BigIskander/PlantWatering/photo/IMG_20230401_112216.jpg

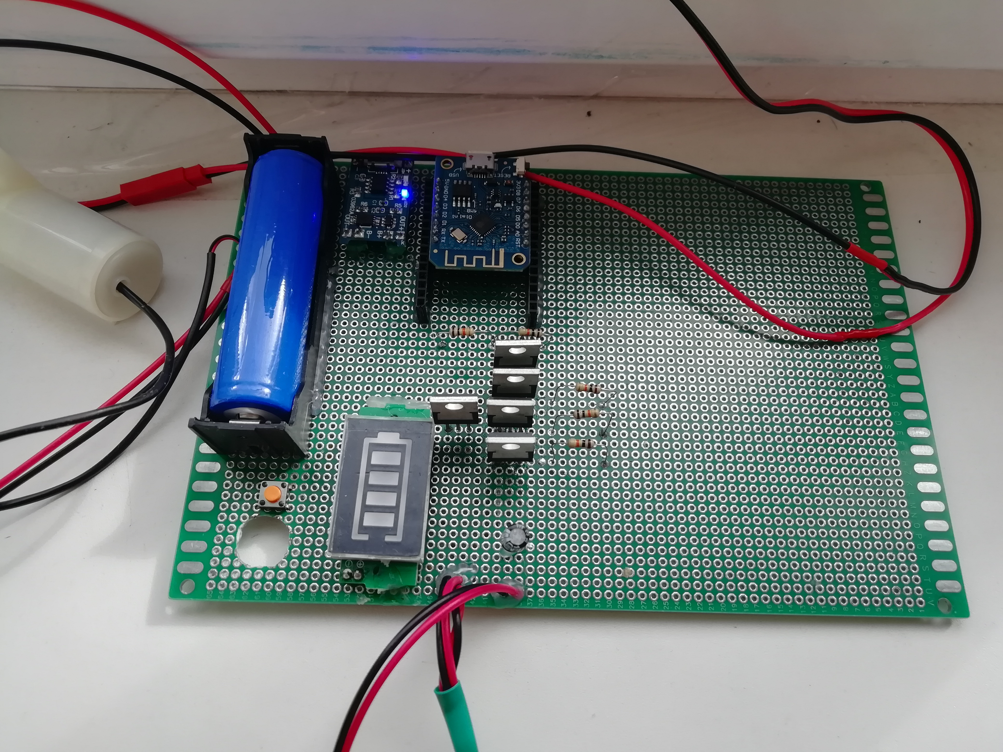
photo/IMG_20230401_112216.jpg
