BigIskander/PlantWatering/photo/IMG_20230612_072729.jpg

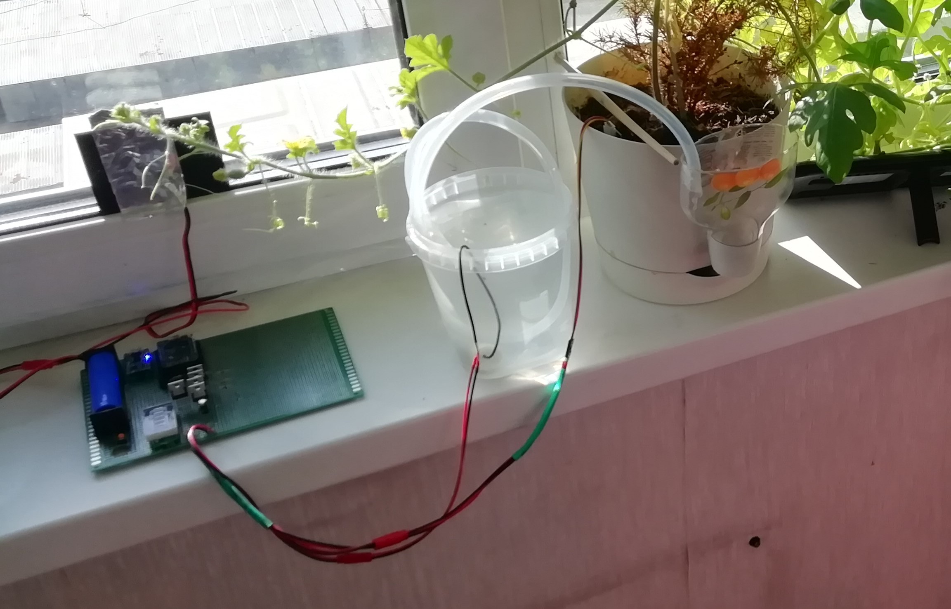
photo/IMG_20230612_072729.jpg
