BigIskander/PlantWatering/photo/moisture2.png

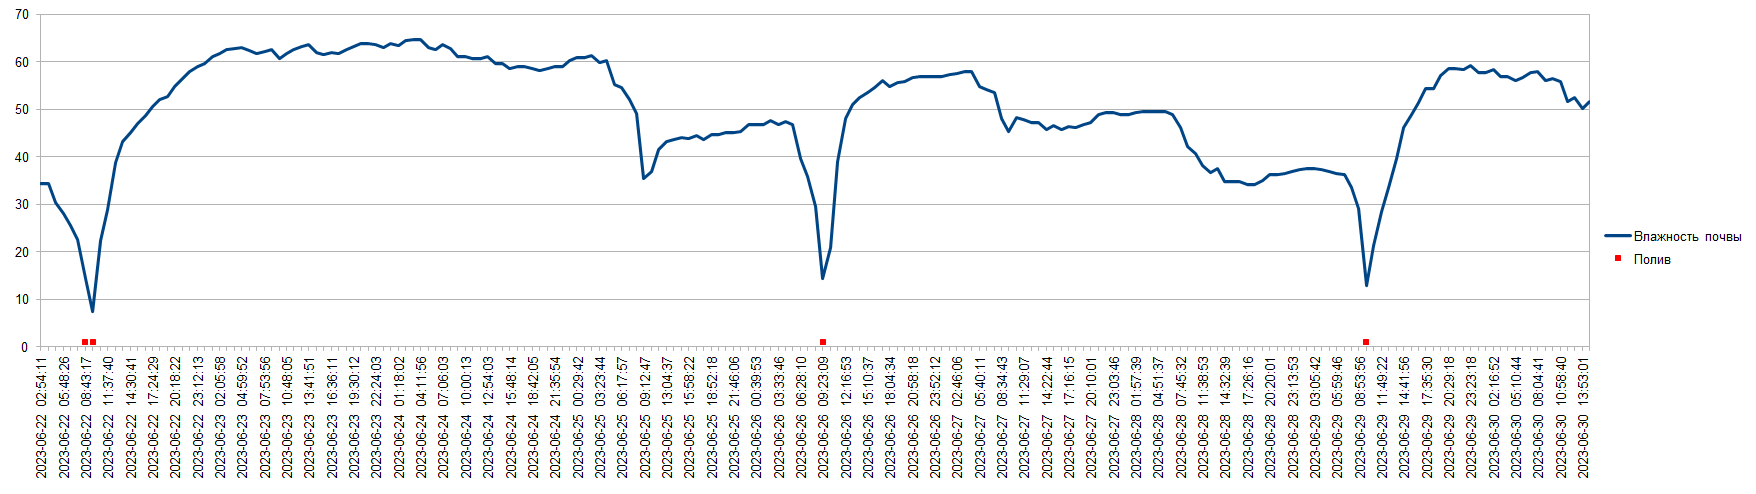
photo/moisture2.png
