BigIskander/PlantWatering/photo/moisture.png

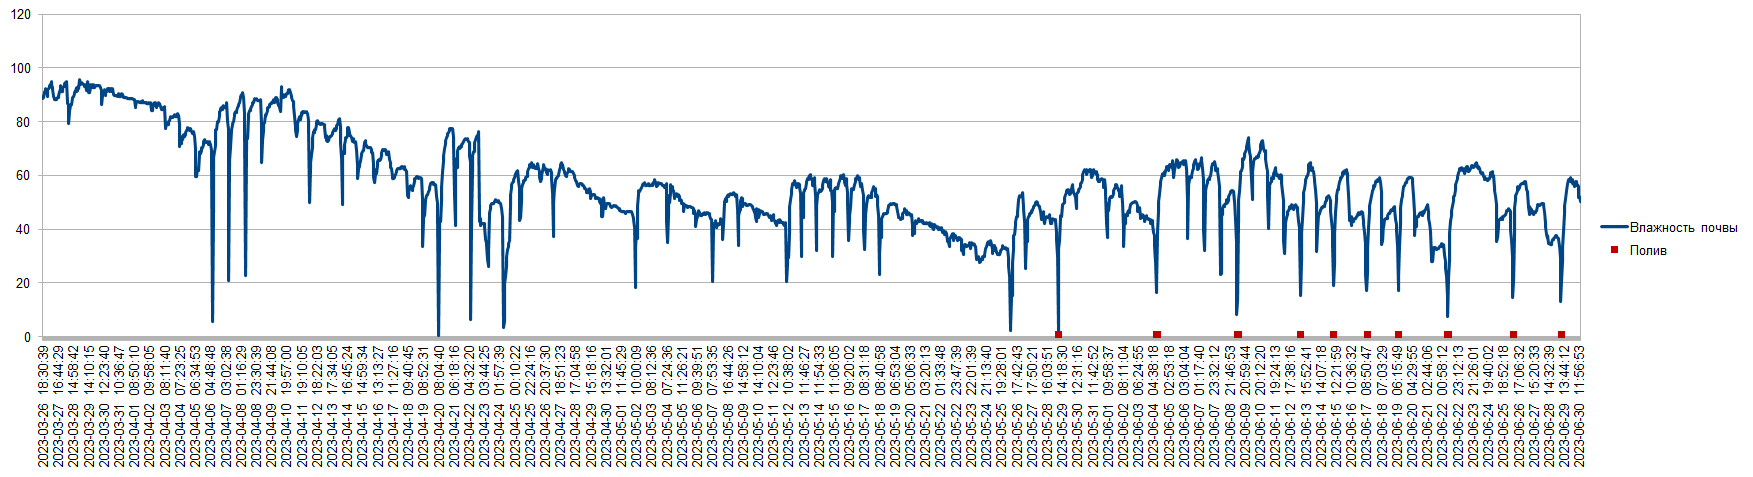
photo/moisture.png
