BigIskander/PlantWatering/photo/voltage2.png

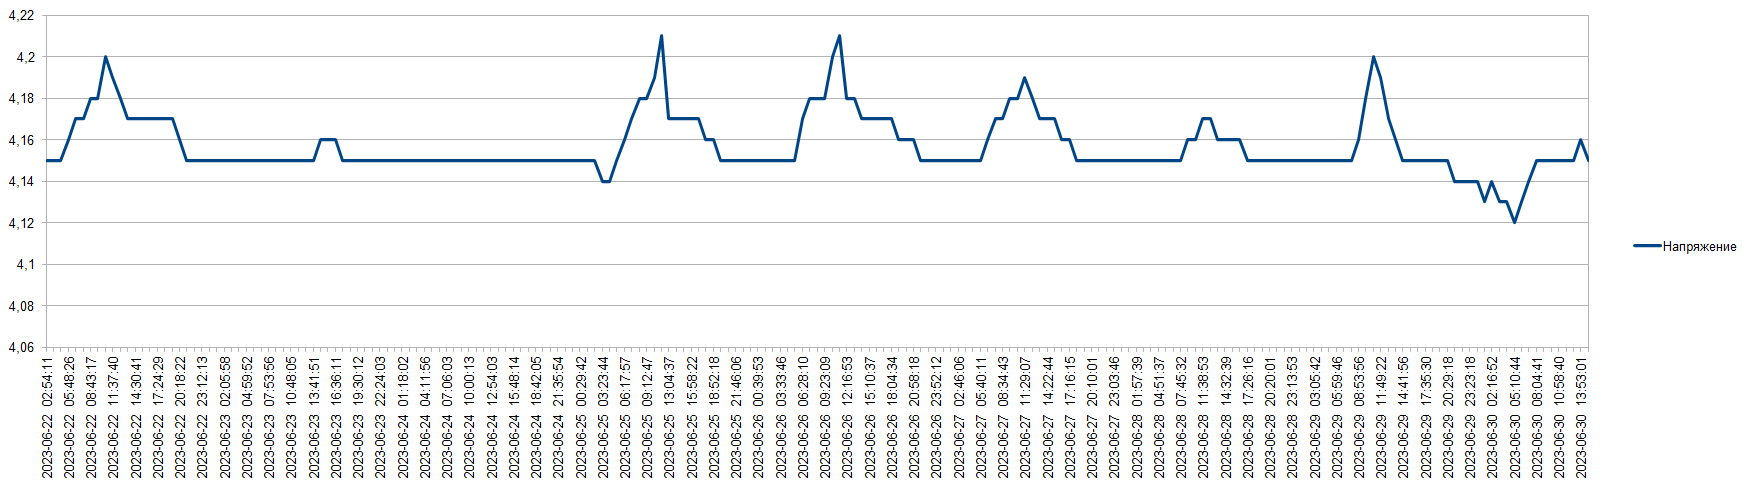
photo/voltage2.png
