BigIskander/PlantWatering/photo/voltage.png

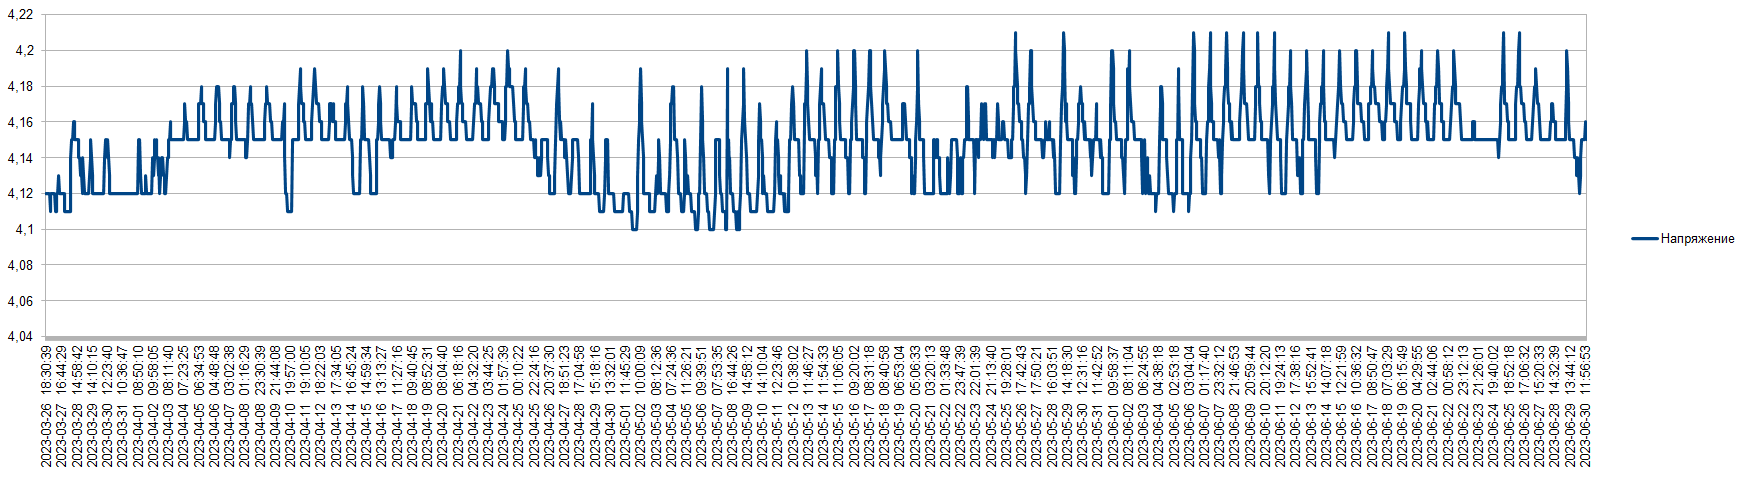
photo/voltage.png
