BigIskander/PlantWatering/(list of files, drawings)

Other design files:
CircuitDiagram/PlantWatering.dch
